mbcallahan/MATE/old code/readme.md

Old code from Christian  
Original repositories here: 
https://github.com/computer-whisperer
