mbcallahan/MATE/electrical/footprints/readme.md

FC4L64, ODROID-C2 by Connor Crenshaw
PJ-002AH by manufacturer, modified to include silkscreen warning
