mbcallahan/MATE/electrical/control board/BOM 2-4-2019.xlsx

C1 | .22uF | Capacitor_SMD:C_0603_1608Metric_Pad1.05x0.95mm_HandSolder | 490-8017-1-ND | 1
> C2, C3 | 30pF | Capacitor_SMD:C_0603_1608Metric_Pad1.05x0.95mm_HandSolder | 1276-1021-1-ND | 2
> C4, C17 | .1uF | Capacitor_SMD:C_0603_1608Metric_Pad1.05x0.95mm_HandSolder | 1276-1005-1-ND | 2
> C5 - C12 | 100nF | Capacitor_SMD:C_0603_1608Metric_Pad1.05x0.95mm_HandSolder | 1276-1005-1-ND | 8
> C13, C14 | 1uF | Capacitor_SMD:C_0603_1608Metric_Pad1.05x0.95mm_HandSolder | 1276-1102-1-ND | 2
> C15, C16 | 10uF | Capacitor_SMD:C_0603_1608Metric_Pad1.05x0.95mm_HandSolder | 490-10728-1-ND | 2
C18 | 2.2uF | Capacitor_SMD:C_0603_1608Metric_Pad1.05x0.95mm_HandSolder | 490-10731-1-ND | 1
> D1, D4 | LED-RED | LED_SMD:LED_0603_1608Metric_Pad1.05x0.95mm_HandSolder | SML-D12U1WT86CT-ND | 2
> D2, D5 | LED-YELLOW | LED_SMD:LED_0603_1608Metric_Pad1.05x0.95mm_HandSolder | 160-1448-1-ND | 2
> D3, D6 | LED-GREEN | LED_SMD:LED_0603_1608Metric_Pad1.05x0.95mm_HandSolder | 160-1446-1-ND | 2
J1 | analog_extra | Connector_PinHeader_2.54mm:PinHeader_1x02_P2.54mm_Vertical | HDR100IMP40M-G-V-TH-ND | 1
J2 | Programming_Header | Connector_PinHeader_2.54mm:PinHeader_1x06_P2.54mm_Vertical | HDR100IMP40M-G-V-TH-ND | 1
J3 | USB_B | Connector_USB:USB_B_OST_USB-B1HSxx_Horizontal | UE27BC54130-ND | 1
J4 | datamate_sensors | Connector_Harwin:Harwin_LTek-Male_04_P2.00mm_Vertical | 952-1071-5-ND | 1
J5 | Motor_1 | Connector_Harwin:Harwin_LTek-Male_03_P2.00mm_Vertical | 952-1070-5-ND‎ | 1
J6 | datamate_misc | Connector_Harwin:Harwin_LTek-Male_04_P2.00mm_Vertical | 952-1071-5-ND | 1
J7 | Power_Connector | Connector_Molex:Molex_Mini-Fit_Jr_5566-08A2_2x04_P4.20mm_Vertical | WM3803-ND | 1
J8 | Power_Header | footprints:1x2 individual header | HDR100IMP40M-G-V-TH-ND | 1
J9 | Switch_Connector | Connector_Harwin:Harwin_LTek-Male_06_P2.00mm_Vertical | 952-1072-5-ND | 1
J10 | Motor_2 | Connector_Harwin:Harwin_LTek-Male_03_P2.00mm_Vertical | 952-1070-5-ND‎ | 1
J11 | Motor_3 | Connector_Harwin:Harwin_LTek-Male_03_P2.00mm_Vertical | 952-1070-5-ND‎ | 1
J12 | Motor_4 | Connector_Harwin:Harwin_LTek-Male_03_P2.00mm_Vertical | 952-1070-5-ND‎ | 1
J13 | Motor_5 | Connector_Harwin:Harwin_LTek-Male_03_P2.00mm_Vertical | 952-1070-5-ND‎ | 1
J14 | Motor_6 | Connector_Harwin:Harwin_LTek-Male_03_P2.00mm_Vertical | 952-1070-5-ND‎ | 1
J15 | Motor_7 | Connector_Harwin:Harwin_LTek-Male_03_P2.00mm_Vertical | 952-1070-5-ND‎ | 1
J16 | Motor_8 | Connector_Harwin:Harwin_LTek-Male_03_P2.00mm_Vertical | 952-1070-5-ND‎ | 1
J17 | USB_to_5V | Connector_PinHeader_2.54mm:PinHeader_1x02_P2.54mm_Vertical | HDR100IMP40M-G-V-TH-ND | 1
J18 | Storage | Connector_PinHeader_2.54mm:PinHeader_1x02_P2.54mm_Vertical | HDR100IMP40M-G-V-TH-ND | 1
P1 | ODROID-C2 | footprints:ODROID-C2 | SAM9012-ND | 1
Q2 | DTC114E | Package_TO_SOT_SMD:SOT-23 | DTC114EET1GOSCT-ND | 1
> R1, R2 | 2.2k | Resistor_SMD:R_0603_1608Metric_Pad1.05x0.95mm_HandSolder | A130093CT-ND | 2
> R3 - R13 | 10k | Resistor_SMD:R_0603_1608Metric_Pad1.05x0.95mm_HandSolder | CR0603-JW-103ELFCT-ND | 4
R8 | 56k | Resistor_SMD:R_0603_1608Metric_Pad1.05x0.95mm_HandSolder | RMCF0603JT56K0CT-ND | 1
> R9 - R19 | 220 | Resistor_SMD:R_0603_1608Metric_Pad1.05x0.95mm_HandSolder | A130087CT-ND | 6
R14 | 12k | Resistor_SMD:R_0603_1608Metric_Pad1.05x0.95mm_HandSolder | CR0603-JW-123ELFCT-ND | 1
R15 | 100k | Resistor_SMD:R_0603_1608Metric_Pad1.05x0.95mm_HandSolder | CR0603-JW-104ELFCT-ND | 1
R16 | 3.6k | Resistor_SMD:R_0603_1608Metric_Pad1.05x0.95mm_HandSolder | RMCF0603JT3K60CT-ND | 1
SW1 | SW_Push | Button_Switch_SMD:SW_SPST_PTS645 | PTS645SM43SMTR92 LFS | 1
U1 | STM32F446RETx | footprints:LQFP-64_10x10mm_P0.5mm_handsolder | 497-15376-ND | 1
U2 | HIH6131-021 | Package_SO:SOIC-8_3.9x4.9mm_P1.27mm | 480-3652-1-ND | 1
U3 | LD1117S33TR_SOT223 | Package_TO_SOT_SMD:SOT-223-3_TabPin2 | 497-1242-1-ND | 1
U5 | BMI160 | Package_LGA:LGA-14_3x2.5mm_P0.5mm_LayoutBorder3x4y | 828-1057-1-ND | 1
> U4, U6 | ADM3061 | Package_SO:TSSOP-8_3x3mm_P0.65mm | ADM3061EARMZ-ND | 2
Y1 | 8Mhz | Crystal:Crystal_HC49-U_Vertical | CTX917-ND‎ | 1
 |  | 6 wire ribbon cable | 1568-1938-ND | 1
 |  | Molex cable | WM8399-ND | 2
 |  | Datamate female | 952-1764-ND | 8
 |  | Jumper | S9337-ND | 1
