mbcallahan/MATE/electrical/control board/pin budget.xlsx

Item | Number of item | I2C | UART | GPIO | Analog
HIH6031 | 1 | 1 | 0 | 0 | 0
INA 240 | 1 | 0 | 0 | 0 | 1
ADM3061(RS485) | 3 | 0 | 1 | 0 | 0
ICM20648 (measury thingy) | 1 | 1 | 0 | 0 | 0
Odroid | 1 | 0 | 1 | 0 | 0
5V | 1 | 0 | 0 | 0 | 1
3.3V | 1 | 0 | 0 | 0 | 1
48V | 1 | 0 | 0 | 0 | 1
low side switch | 4 | 0 | 0 | 1 | 0
debug LED | 5 | 0 | 0 | 1 | 0
motor driver | 8 | 0 | 0 | 1 | 0 | Total pins:
Total | 27 | 2 | 4 | 17 | 4 | 33
Microcontroller | Package | I2C | UART | GPIO | Analog | Total (pins, not interfaces) | Notes
STM32 | SMD 64 | 2 | 4 | 20 | 20 | 48 | All GPIOs are also analog inputs
ATMEGA328p | SMD 32 |  | 1 | 20 | 8 | 26 | 6 analog inputs are also GPIOs
AtMega64 | SMD 64
