mbcallahan/MATE/(list of files, cad)

Other CAD files:
electrical/control board/outline.FCStd
electrical/control board/outline.dxf
