mbcallahan/MATE/electrical/control board power/control board power.kicad_pcb

## KiCad design electrical/control board power/control board power.kicad_pcb (2019-03-28)

Schematic: control board power.sch

Parts:
C1, C2: 10uF; C_0603_1608Metric_Pad1.05x0.95mm_HandSolder; Digikey part number 490-7198-1-ND
C3, C4, C19, C20: 2.2uF; C_1210_3225Metric_Pad1.42x2.65mm_HandSolder; Digikey part number 445-4497-1-ND
C5, C7: 1uF; C_0603_1608Metric_Pad1.05x0.95mm_HandSolder; Digikey part number 478-5010-1-ND
C6, C8: .1uF; C_0603_1608Metric_Pad1.05x0.95mm_HandSolder; Digikey part number 399-1100-1-ND
C9: 10pF; C_0603_1608Metric_Pad1.05x0.95mm_HandSolder; Digikey part number 732-7760-1-ND
C10: 2.2nF; C_0603_1608Metric_Pad1.05x0.95mm_HandSolder; Digikey part number 732-8003-1-ND
C11: 100pF; C_0603_1608Metric_Pad1.05x0.95mm_HandSolder; Digikey part number 732-7947-1-ND
C12, C13, C15, C16, C17, C18: 22uF; C_1210_3225Metric_Pad1.42x2.65mm_HandSolder; Digikey part number 1276-1855-1-ND
C14, C25, C26, C27: 330u; CP_Radial_D18.0mm_P7.50mm; Digikey part number 493-16707-ND
C21, C22: 0.1uF; C_0805_2012Metric_Pad1.15x1.40mm_HandSolder; Digikey part number 732-12244-1-ND
C23, C24: 10uF; C_1210_3225Metric_Pad1.42x2.65mm_HandSolder; Digikey part number 1276-3307-1-ND
D1: LED; LED_0603_1608Metric_Pad1.05x0.95mm_HandSolder_diode_mark; Digikey part number SML-D12U1WT86CT-ND
D2: LED; LED_0603_1608Metric_Pad1.05x0.95mm_HandSolder_diode_mark; Digikey part number 160-1446-1-ND
D3: LED; LED_0603_1608Metric_Pad1.05x0.95mm_HandSolder_diode_mark; Digikey part number 846-1178-2-ND
D4, D5: LED; LED_0603_1608Metric_Pad1.05x0.95mm_HandSolder_diode_mark; Digikey part number 1830-1071-1-ND
D8: LED; LED_0603_1608Metric_Pad1.05x0.95mm_HandSolder_diode_mark; Digikey part number 754-2180-1-ND
D9, D10: D_Small; D_SMC_Handsoldering_Diode_Mark; Digikey part number SMCJ150CALFCT-ND
J1: Conn_01x02; Molex_Mini-Fit_Jr_5566-02A_2x01_P4.20mm_Vertical; Digikey part number N/A
J2: 5V; PinHeader_1x02_P2.54mm_Vertical; Digikey part number N/A
J3: Barrel_Jack; CUI_PJ-002AH; Digikey part number CP-002AH-ND
J4: Switch_A; Molex_Mini-Fit_Jr_5566-02A_2x01_P4.20mm_Vertical; Digikey part number WM8360-ND
J5: Conn_01x03; Harwin_LTek-Male_03_P2.00mm_Vertical
J6: Power_Connector; Molex_Mini-Fit_Jr_5566-08A2_2x04_P4.20mm_Vertical; Digikey part number WM3803-ND
J7: Switch_A_High; Square_Pad_6mm; Digikey part number N/A
J8: Switch_B_High; Square_Pad_6mm; Digikey part number N/A
J9: Aux_1; Molex_Mini-Fit_Jr_5566-04A_2x02_P4.20mm_Vertical; Digikey part number WM8359-ND
J10: 48V_from_conversion; Molex_Mini-Fit_Jr_5566-02A_2x01_P4.20mm_Vertical; Digikey part number WM8360-ND
J11: Aux_2; Molex_Mini-Fit_Jr_5566-04A_2x02_P4.20mm_Vertical; Digikey part number WM8359-ND
J12, J13: Conn_01x04; TerminalBlock_TE_282834-4_1x04_P2.54mm_Horizontal; Digikey part number A98335-ND
J17: Switch_B; Molex_Mini-Fit_Jr_5566-02A_2x01_P4.20mm_Vertical; Digikey part number WM8360-ND
L1, L2: 33uH; L_Radial_D12.0mm_P6.00mm_MuRATA_1900R; Digikey part number 6100-330K-RC-ND
Q1, Q2: Q_NMOS_GDS; TO-252-3_2_Pin; Digikey part number BTS3046SDRATMA1CT-ND
R1: 330; R_0603_1608Metric_Pad1.05x0.95mm_HandSolder; Digikey part number CR0603-JW-331ELFCT-ND
R2, R12, R13: 150; R_0603_1608Metric_Pad1.05x0.95mm_HandSolder; Digikey part number RMCF0603JT150RCT-ND
R3: 9.4k; R_1206_3216Metric_Pad1.42x1.75mm_HandSolder; Digikey part number 408-1867-1-ND
R4, R5: 10k; R_0603_1608Metric_Pad1.05x0.95mm_HandSolder; Digikey part number N/A
R7: 100k; R_0603_1608Metric_Pad1.05x0.95mm_HandSolder; Digikey part number 311-100KHRCT-ND
R8: 4.02k; R_0603_1608Metric_Pad1.05x0.95mm_HandSolder; Digikey part number RMCF0603FT4K02CT-ND
R10: 5.11k; R_0603_1608Metric_Pad1.05x0.95mm_HandSolder; Digikey part number RMCF0603FT5K11CT-ND
R16: 2.7k; R_1206_3216Metric_Pad1.42x1.75mm_HandSolder; Digikey part number 408-1906-1-ND
TB1: Curtis_2010; Digikey part number 364-1381-ND
TB2: Curtis_2010; Digikey part number 364-1381-ND
U1: LD1117S33TR_SOT223; SOT-223-3_TabPin2; Digikey part number 497-1242-1-ND
U2, U3: LTC7103-LT7103; LTC7103_long_pads_hole; Digikey part number LTC7103HUHE#TRPBFCT-ND

Connections:
+3V3: C2.1, C25.1, J6.5, J9.3, J11.3, R2.2, U1.2 (VO)
+5V: C1.1, C12.1, C13.1, C14.1, C15.1, C16.1, C17.1, C18.1, J2.1, J6.6, J9.4, J11.4, J12.1, J12.3, J13.1, J13.3, L1.2, L2.2, R1.2, U1.3 (VI), U2.20, U3.10, U3.20
+24V: C26.1, J1.1, J1.2, J6.7, R16.1
+48V: C3.1, C4.1, C19.1, C20.1, C21.1, C22.1, C27.1, J3.1, J6.8, J10.1, J10.2, R3.1, U2.3, U2.30, U2.31, U2.32, U3.3, U3.30, U3.31, U3.32
/SWITCH_A: J5.1, Q1.1, R4.1, R12.2
/SWITCH_A_HIGH: C23.2, D9.1, J4.1, J7.1
/SWITCH_B: J5.2, Q2.1, R5.1, R13.2
/SWITCH_B_HIGH: C24.2, D10.1, J8.1, J17.1
GND: C1.2, C2.2, C3.2, C4.2, C5.2, C7.2, C9.2, C11.1, C12.2, C13.2, C14.2, C15.2, C16.2, C17.2, C18.2, C19.2, C20.2, C21.2, C22.2, C23.1, C24.1, C25.2, C26.2, C27.2, D1.1, D2.1, D3.1, D4.1, D5.1, D8.1, J2.2, J3.2, J5.3, J6.1, J6.2, J6.3, J6.4, J9.1, J9.2, J11.1, J11.2, J12.2, J12.4, J13.2, J13.4, Q1.3, Q2.3, R4.2, R5.2, R8.2, R10.2, U1.1 (GND), U2.6, U2.7, U2.11, U2.35, U2.36, U2.37, U3.6, U3.7, U3.11, U3.19, U3.35, U3.36, U3.37
unnamed: C5.1, U2.10, U2.21
unnamed: C6.1, U2.27
unnamed: C6.2, L1.1, U2.24, U2.25, U2.26
unnamed: C7.1, R7.2, U3.21
unnamed: C8.1, U3.27
unnamed: C8.2, L2.1, U3.24, U3.25, U3.26
unnamed: C9.1, U2.9
unnamed: C10.1, R10.1
unnamed: C10.2, C11.2, U2.16, U3.9
unnamed: D1.2, R1.1
unnamed: D2.2, R2.1
unnamed: D3.2, R3.2
unnamed: D4.2, R12.1
unnamed: D5.2, R13.1
unnamed: D8.2, R16.2
unnamed: D9.2, J4.2, Q1.2
unnamed: D10.2, J17.2, Q2.2
unnamed: R7.1, U3.12
unnamed: R8.1, U2.8
unnamed: U2.12, U3.13
unnamed: U2.15, U3.15

Notes on the sheet:
Power Indicators
Power
Check regulator is correct voltage
Check capacitor voltage ratings!!!
Look at Connor's 5V converter board to check component ratings, etc.
DO NOT CONNECT 12V AND 48V SIMUTANIOUSLY!!!!
Note: Stack terminal blocks

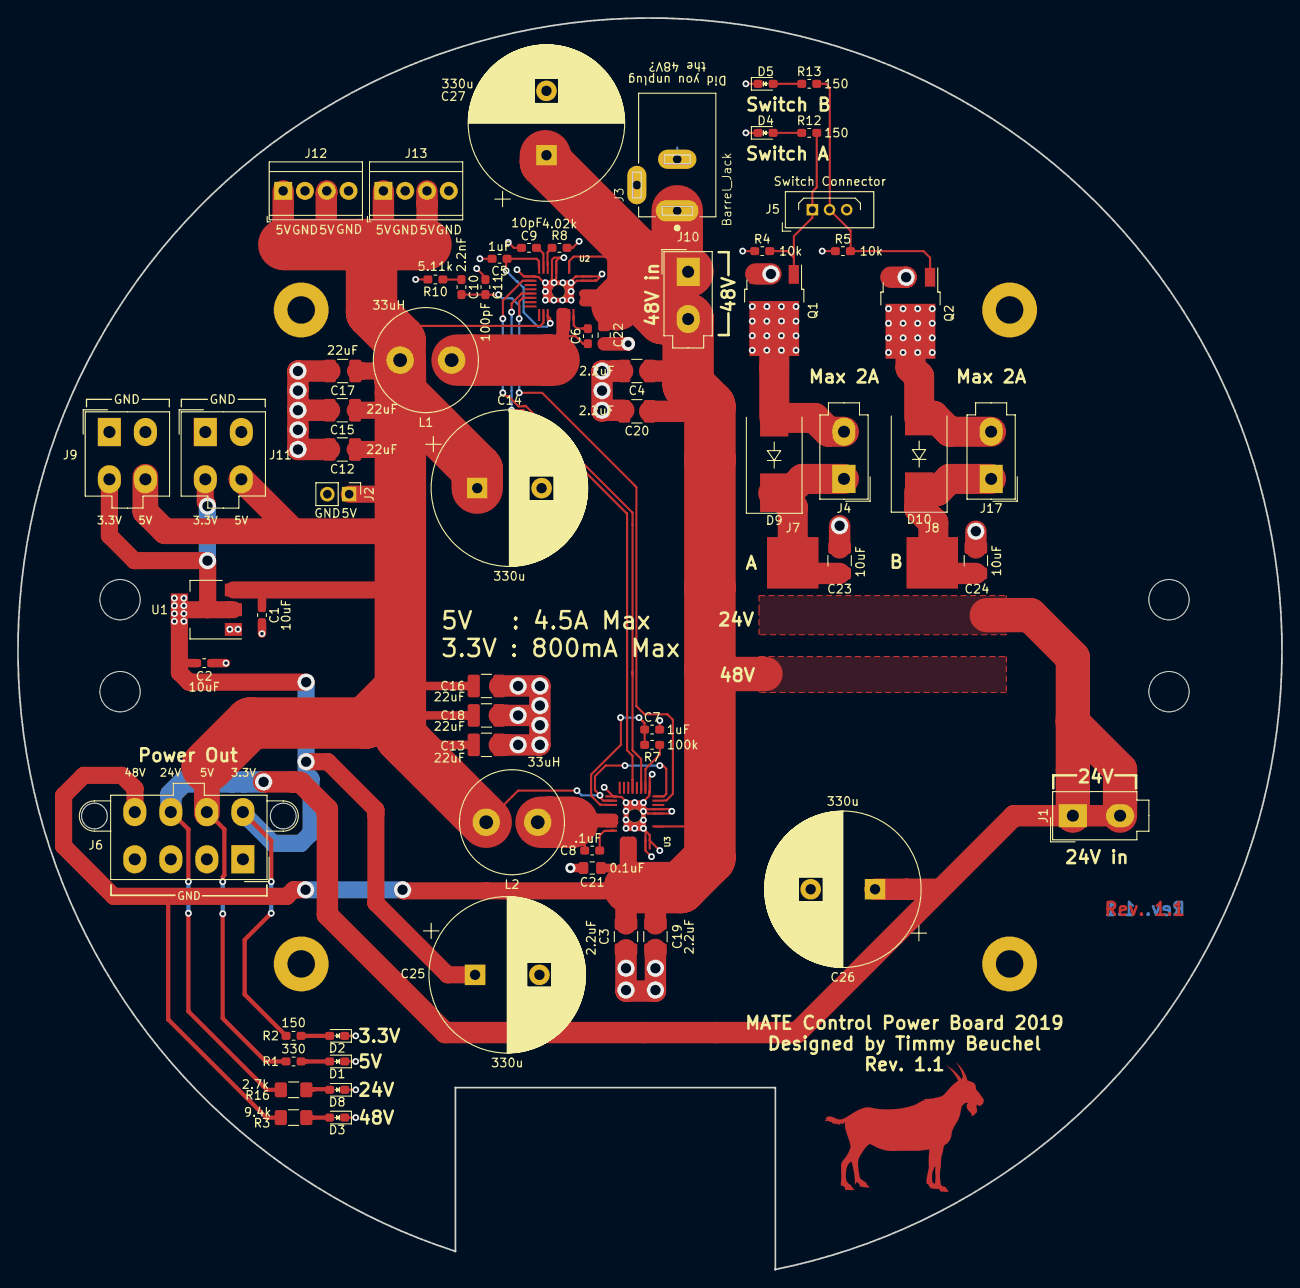
[picture p4: board control board power.kicad_pcb from above]

Board: 2 copper layers, 147.3 x 145.8 mm, 68 parts (1 on the bottom side), 30 nets.
