mbcallahan/MATE/electrical/control board/control board.kicad_pcb

## KiCad design electrical/control board/control board.kicad_pcb (2019-02-27)

Schematic: control board.sch

Parts:
C1: .22uF; C_0603_1608Metric_Pad1.05x0.95mm_HandSolder; Digikey part number 490-8017-1-ND
C2, C3: 30pF; C_0603_1608Metric_Pad1.05x0.95mm_HandSolder; Digikey part number 1276-1021-1-ND
C4, C17: .1uF; C_0603_1608Metric_Pad1.05x0.95mm_HandSolder; Digikey part number 1276-1005-1-ND
C5, C6, C7, C8, C9, C10, C11, C12: 100nF; C_0603_1608Metric_Pad1.05x0.95mm_HandSolder; Digikey part number 1276-1005-1-ND
C13, C14: 1uF; C_0603_1608Metric_Pad1.05x0.95mm_HandSolder; Digikey part number 1276-1102-1-ND
C15, C16: 10uF; C_0603_1608Metric_Pad1.05x0.95mm_HandSolder; Digikey part number 490-10728-1-ND
C18: 2.2uF; C_0603_1608Metric_Pad1.05x0.95mm_HandSolder; Digikey part number 490-10731-1-ND
D1, D4: LED-RED; LED_0603_1608Metric_Pad1.05x0.95mm_HandSolder; Digikey part number SML-D12U1WT86CT-ND
D2, D5, D7: LED-YELLOW; LED_0603_1608Metric_Pad1.05x0.95mm_HandSolder; Digikey part number 160-1448-1-ND
D3, D6, D8: LED-GREEN; LED_0603_1608Metric_Pad1.05x0.95mm_HandSolder; Digikey part number 160-1446-1-ND
J1: analog_extra; PinHeader_1x02_P2.54mm_Vertical; Digikey part number HDR100IMP40M-G-V-TH-ND
J2: Programming_Header; PinHeader_1x06_P2.54mm_Vertical; Digikey part number HDR100IMP40M-G-V-TH-ND
J3: USB_B; USB_B_OST_USB-B1HSxx_Horizontal; Digikey part number UE27BC54130-ND
J4: datamate_sensors; Harwin_LTek-Male_04_P2.00mm_Vertical; Digikey part number 952-1071-5-ND
J5: Motor_1; Harwin_LTek-Male_03_P2.00mm_Vertical; Digikey part number 952-1070-5-ND‎
J6: datamate_misc; Harwin_LTek-Male_04_P2.00mm_Vertical; Digikey part number 952-1071-5-ND
J7: Power_Connector; Molex_Mini-Fit_Jr_5566-08A2_2x04_P4.20mm_Vertical; Digikey part number WM3803-ND
J8: Power_Header; 1x2 individual header; Digikey part number HDR100IMP40M-G-V-TH-ND
J9: Switch_Connector; Harwin_LTek-Male_06_P2.00mm_Vertical; Digikey part number 952-1072-5-ND
J10: Motor_2; Harwin_LTek-Male_03_P2.00mm_Vertical; Digikey part number 952-1070-5-ND‎
J11: Motor_3; Harwin_LTek-Male_03_P2.00mm_Vertical; Digikey part number 952-1070-5-ND‎
J12: Motor_4; Harwin_LTek-Male_03_P2.00mm_Vertical; Digikey part number 952-1070-5-ND‎
J13: Motor_5; Harwin_LTek-Male_03_P2.00mm_Vertical; Digikey part number 952-1070-5-ND‎
J14: Motor_6; Harwin_LTek-Male_03_P2.00mm_Vertical; Digikey part number 952-1070-5-ND‎
J15: Motor_7; Harwin_LTek-Male_03_P2.00mm_Vertical; Digikey part number 952-1070-5-ND‎
J16: Motor_8; Harwin_LTek-Male_03_P2.00mm_Vertical; Digikey part number 952-1070-5-ND‎
J17: USB_to_5V; PinHeader_1x02_P2.54mm_Vertical; Digikey part number HDR100IMP40M-G-V-TH-ND
J18: Storage; PinHeader_1x02_P2.54mm_Vertical; Digikey part number HDR100IMP40M-G-V-TH-ND
P1: ODROID-C2; Digikey part number SAM9012-ND
Q2: DTC114E; SOT-23; Digikey part number DTC114EET1GOSCT-ND
R1, R2: 2.2k; R_0603_1608Metric_Pad1.05x0.95mm_HandSolder; Digikey part number A130093CT-ND
R3, R4, R7, R13: 10k; R_0603_1608Metric_Pad1.05x0.95mm_HandSolder; Digikey part number CR0603-JW-103ELFCT-ND
R5, R9, R10, R11, R17, R18, R19: 68; R_0603_1608Metric_Pad1.05x0.95mm_HandSolder; Digikey part number RMCF0603JT68R0CT-ND
R6: 180; R_0603_1608Metric_Pad1.05x0.95mm_HandSolder
R8: 56k; R_0603_1608Metric_Pad1.05x0.95mm_HandSolder; Digikey part number RMCF0603JT56K0CT-ND
R12, R15: 100k; R_0603_1608Metric_Pad1.05x0.95mm_HandSolder; Digikey part number CR0603-JW-104ELFCT-ND
R14: 12k; R_0603_1608Metric_Pad1.05x0.95mm_HandSolder; Digikey part number CR0603-JW-123ELFCT-ND
R16: 3.6k; R_0603_1608Metric_Pad1.05x0.95mm_HandSolder; Digikey part number RMCF0603JT3K60CT-ND
R20: 6.6k; R_0603_1608Metric_Pad1.05x0.95mm_HandSolder; Digikey part number A129698CT-ND
SW1: SW_Push; SW_SPST_PTS645; Digikey part number CKN9112CT-ND
U1: STM32F446RETx; LQFP-64_10x10mm_P0.5mm_handsolder; Digikey part number 497-15376-ND
U2: HIH6131-021; SOIC-8_3.9x4.9mm_P1.27mm; Digikey part number 480-3652-1-ND
U3: LD1117S33TR_SOT223; SOT-223-3_TabPin2; Digikey part number 497-1242-1-ND
U4, U6: ADM3061; TSSOP-8_3x3mm_P0.65mm; Digikey part number ADM3061EARMZ-ND
U5: BMI160; LGA-14_3x2.5mm_P0.5mm_pads_shrunk; Digikey part number 828-1057-1-ND
Y1: 8Mhz; Crystal_HC49-U_Vertical; Digikey part number CTX917-ND‎

Connections:
+3V3: C1.2, C4.2, C5.2, C6.2, C7.2, C8.2, C9.2, C10.2, C11.1, C12.1, C13.1, C14.1, C16.1, J2.1, J7.5, J8.2, R1.1, R2.1, R3.2, R4.2, R5.2, R7.1, U1.1 (VBAT), U1.13 (VDDA), U1.19 (VDD), U1.32 (VDD), U1.48 (VDD), U1.64 (VDD), U2.8, U3.2 (VO), U4.8, U5.5, U5.8, U5.12, U6.8
+5V: J7.6, J17.1, P1.2, P1.4, R6.2, R13.1
+24V: J7.7, R12.1
+48V: J4.1, J6.1, J7.8, R15.1
/3.3V_MEASURE: R7.2, R8.1, U1.8 (PC0)
/5V_MEASURE: R13.2, R14.1, U1.9 (PC1)
/24V_MEASURE: R12.2, R20.1, U1.27 (PB1)
/48V_MEASURE: R15.2, R16.1, U1.10 (PC2)
/CURRENT_MEASURE: U1.11 (PC3)
/HIH_SCL: R1.2, U1.37 (PC6), U2.3
/HIH_SDA: R2.2, U1.38 (PC7), U2.4
/ICM_SCL: R4.1, U1.41 (PA8), U5.13
/ICM_SDA: R3.1, U1.40 (PC9), U5.14
/JTDO: J2.6, U1.55 (PB3)
/MISC_DE: U1.3 (PC14), U6.3
/MISC_RE: U1.2 (PC13), U6.2
/MISC_RX: U1.52 (PC11), U6.1
/MISC_TX: U1.51 (PC10), U6.4
/MOTOR_1: J5.3, U1.4 (PC15)
/MOTOR_2: J10.3, U1.62 (PB9)
/MOTOR_3: J11.3, U1.61 (PB8)
/MOTOR_4: J12.3, U1.57 (PB5)
/MOTOR_5: J13.3, U1.56 (PB4)
/MOTOR_6: J14.3, U1.54 (PD2)
/MOTOR_7: J15.3, U1.53 (PC12)
/MOTOR_8: J16.3, U1.50 (PA15)
/NRST: C17.1, J2.5, Q2.3, SW1.1, U1.7 (NRST)
/ODROID_RX: P1.10, U1.14 (PA0)
/ODROID_TX: P1.8, U1.15 (PA1)
/SENSOR_DE: U1.45 (PA12), U4.3
/SENSOR_RE: U1.44 (PA11), U4.2
/SENSOR_RX: U1.43 (PA10), U4.1
/SENSOR_TX: U1.42 (PA9), U4.4
/STM_RESET: P1.7, Q2.1
/SWCLK: J2.2, U1.49 (PA14)
/SWDIO: J2.4, U1.46 (PA13)
/SWITCH_A: J9.6, U1.29 (PB10)
/SWITCH_B: J9.5, U1.33 (PB12)
/SWITCH_C: J9.4, U1.34 (PB13)
/SWITCH_D: J9.3, U1.35 (PB14)
/SWITCH_E: J9.2, U1.36 (PB15)
/USART1_RX: U1.59 (PB7)
/USART1_TX: U1.58 (PB6)
unnamed: C2.1, U1.5 (PH0), Y1.1
unnamed: C3.1, U1.6 (PH1), Y1.2
unnamed: C4.1, U2.1
unnamed: C15.1, J3.1, J17.2, U3.3 (VI)
unnamed: C18.1, U1.30 (VCAP_1)
unnamed: D1.2, R9.2
unnamed: D2.2, R10.1
unnamed: D3.2, R11.1
unnamed: D4.2, R17.1
unnamed: D5.2, R18.1
unnamed: D6.2, R19.1
unnamed: D7.2, R5.1
unnamed: D8.2, R6.1
unnamed: J1.2, U1.24 (PC4)
unnamed: J4.2, U4.7
unnamed: J4.3, U4.6
unnamed: J6.2, U6.7
unnamed: J6.3, U6.6
unnamed: P1.33, R17.2
unnamed: P1.35, R18.2
unnamed: P1.37, R19.2
unnamed: R9.1, U1.16 (PA2)
unnamed: R10.2, U1.17 (PA3)
unnamed: R11.2, U1.20 (PA4)

Notes on the sheet:
USART6_TX
USART6_RX
UART4 : Odroid UART2 : Motors UART1 : Sensors UART3 : Misc
Voltage Monitering
Consider moving to power board
Add header space for current measurement
Not connected to +5V to avoid overcurrent on USB port attempting to power odroid
Consider adding switch instead

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
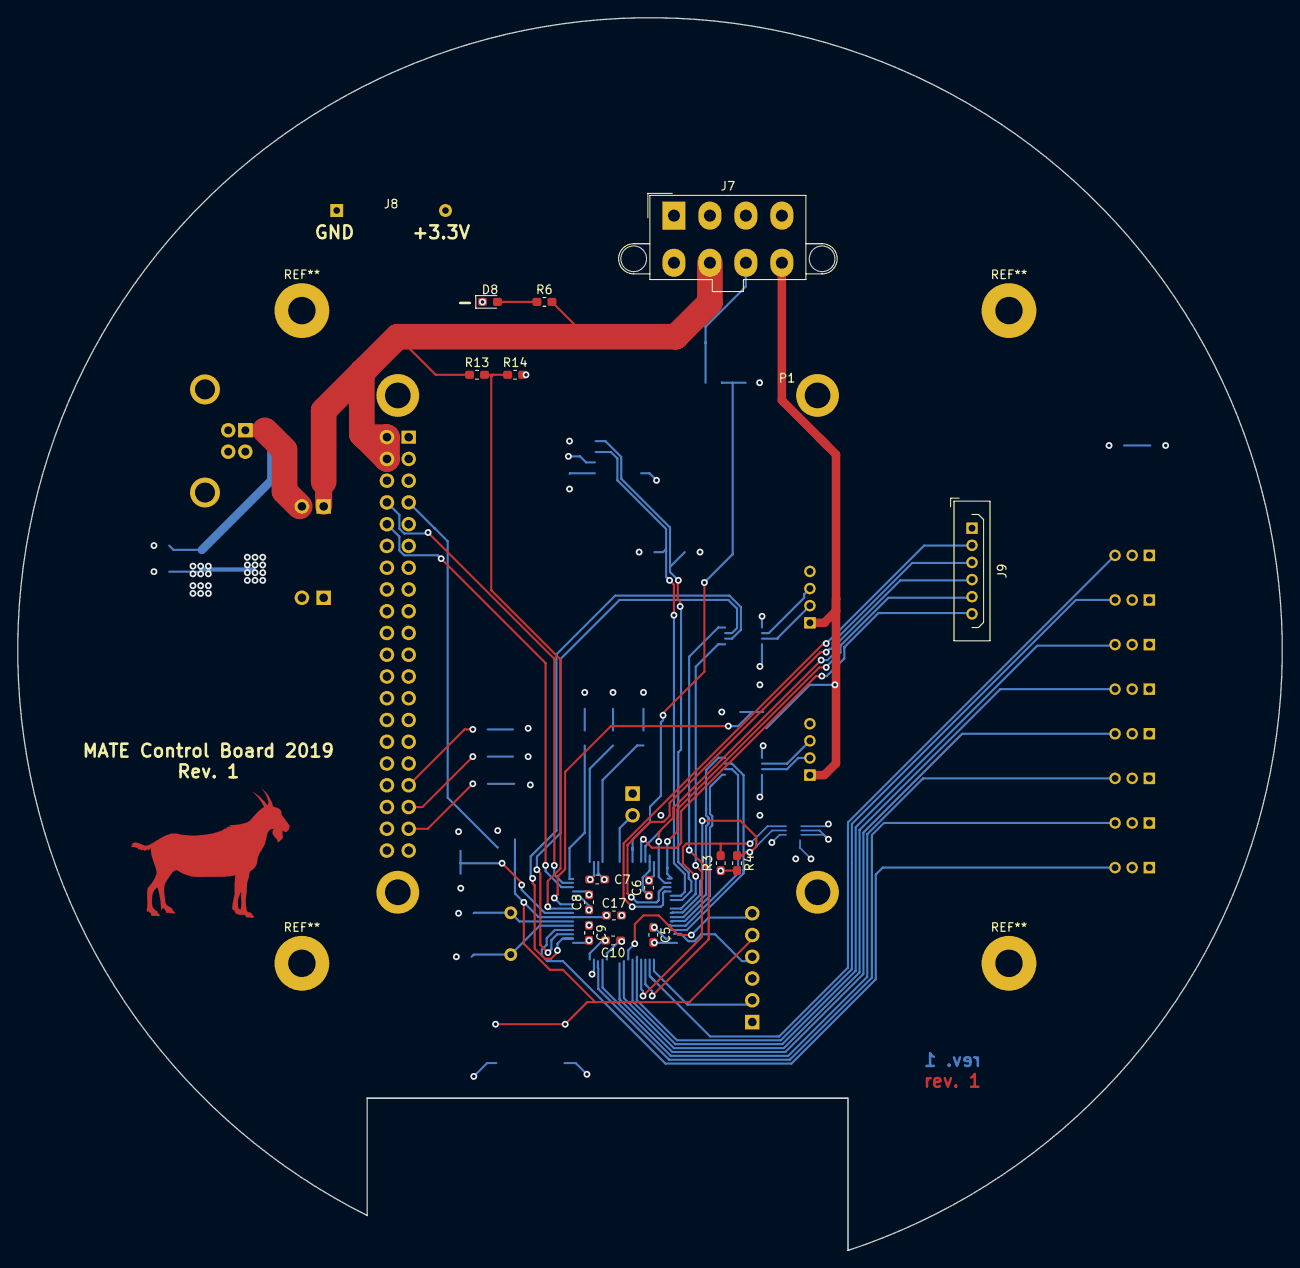
[picture p5: board control board.kicad_pcb from above]

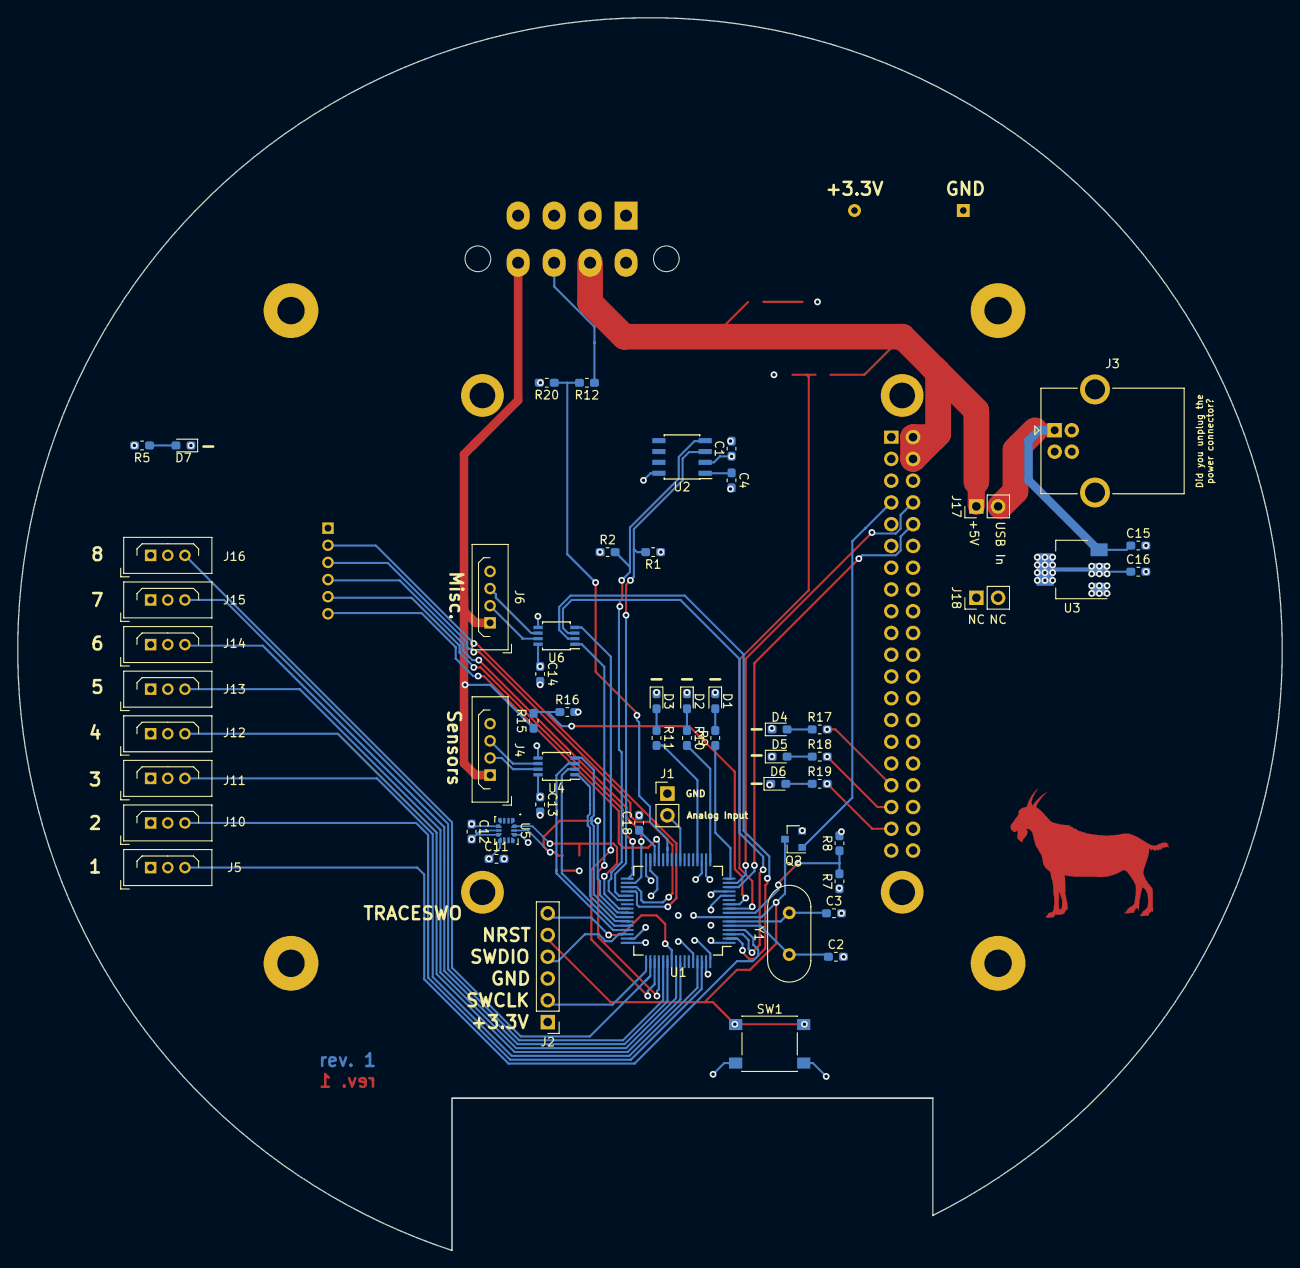
[picture p6: board control board.kicad_pcb from below]

Board: 4 copper layers, 147.6 x 143.9 mm, 74 parts (57 on the bottom side), 65 nets.
