mbcallahan/MATE/(commit log)

2018-12-10 Added old code
    [robot.yml]
2018-12-23 added controlboard
    [control board.kicad_pcb, control board.sch, current budget.xlsx, pin budget.xlsx]
2018-12-23 removed motor communications
    [control board.sch]
2018-12-23 new interface with motor drivers
    [control board.sch]
2018-12-24 deleted previous board
    [control board.kicad_pcb]
2018-12-24 moved power section of control board into a seperate project
    [control board power.kicad_pcb, control board power.sch]
2018-12-24 made a mess, then fixed it
    [control board power.sch, control board.sch]
2018-12-24 transfered power section to a new project
    for real this time
    [control board power.sch, control board.sch]
2018-12-25 Finally got the correct board outline in Kicad
    [_saved_control board.sch, control board power.kicad_pcb, control board.sch, outline.FCStd, outline.dxf]
2018-12-25 the correct board outline is now in the correct project
    For real this time, I promise
    [control board.kicad_pcb]
2018-12-25 some work on board
    [control board.kicad_pcb]
2018-12-25 Added footprint for power connector
    [_saved_control board.sch, control board.sch]
2018-12-25 Moved current measurement to power board
    [control board power.sch, control board.kicad_pcb, control board.sch]
2018-12-25 forgot to remove current measurement from pcb
    [control board.kicad_pcb]
2018-12-26 routed voltage measurement
    [control board.kicad_pcb, control board.sch]
2018-12-26 found a crystal
    [control board.kicad_pcb, control board.sch]
2018-12-27 Found parts for LEDs
    [control board.kicad_pcb, control board.sch]
2018-12-27 leds are sort of aded
    [_saved_control board.sch, control board.kicad_pcb]
2018-12-27 destoryed a lot of stuff around the microcontroller
    [control board.kicad_pcb]
2018-12-27 created hand solder footprint for microcontoller
    [_saved_control board.sch, control board.sch]
2018-12-27 Changed pins on motors
    [control board.kicad_pcb, control board.sch]
2018-12-28 board is mostly routed
    [control board.kicad_pcb]
2018-12-28 control board is almost finished
    [control board.kicad_pcb]
2018-12-28 added low side switches to control board power
    [control board power.sch, control board.kicad_pcb]
2018-12-30 made a footprint with long pads and a hole in the middle
    [control board power.kicad_pcb, control board power.sch]
2018-12-30 made a mess
    [control board power.kicad_pcb]
2018-12-30 fixed the mess
    [control board power.kicad_pcb]
2018-12-31 more stuff
    [control board power.kicad_pcb]
2018-12-31 found a part for the barrel jack
    [control board power.kicad_pcb, control board power.sch]
2019-01-08 found parts for most of the stuff on the control board
    [control board power.kicad_pcb, control board power.sch, control board.sch, test.csv]
2019-01-08 replaced the footprints of the data headers
    [control board.kicad_pcb]
2019-01-08 replaced the motor headers
    [control board.kicad_pcb, control board.sch]
2019-02-02 capacitors are no longer in microcontroller
    [control board.kicad_pcb]
2019-02-02 replaced sensor with BMI160
    [control board.sch]
2019-02-02 routed new acceleration sensor
    [control board.kicad_pcb, control board.sch]
2019-02-02 placed mounting holes (m3 for now)
    [control board.kicad_pcb]
2019-02-02 added usb port and linear regulator
    [control board.kicad_pcb, control board.sch]
2019-02-02 moved motor headers
    [control board.kicad_pcb]
2019-02-02 replaced humidity sensor with one that exists
    [control board.sch]
2019-02-02 mostly finished routing control board
    [control board.kicad_pcb, control board.sch]
2019-02-02 added capacitors to linear regulator
    [control board.kicad_pcb, control board.sch]
2019-02-02 Added pads to access internal layers
    [control board.kicad_pcb, control board.sch]
2019-02-02 Marked diode polarity
    [control board.kicad_pcb]
2019-02-02 added reset button
    [control board.kicad_pcb, control board.sch]
2019-02-02 connected stuff
    [control board.kicad_pcb]
2019-02-03 Added low side switch connector
    [control board.kicad_pcb, control board.sch]
2019-02-03 rerouted some things
    [control board.kicad_pcb]
2019-02-03 cleaned up tracks and vias
    [control board.kicad_pcb]
2019-02-03 Fixed solder mask distance
    [control board.kicad_pcb]
2019-02-03 labelled stuff
    [control board.kicad_pcb]
2019-02-03 control board should be ready to order
    [control board.kicad_pcb]
2019-02-03 Found some part numbers
    [control board.sch]
2019-02-03 Found all part numbers
    [control board.sch]
2019-02-04 tweaked usb port
    [control board power.kicad_pcb, control board.kicad_pcb, control board.sch]
2019-02-05 Added power leds and bugfixes
    [_saved_control board.sch, control board.kicad_pcb, control board.sch]
2019-02-05 Added power indicators
    [control board.sch]
2019-02-05 Added 24V measurement
    [control board.kicad_pcb, control board.sch]
2019-02-05 Found parts
    [control board.kicad_pcb, control board.sch]
2019-02-05 Generated gerber files
    [control board-B.Cu.gbl, control board-B.Mask.gbs, control board-B.SilkS.gbo, control board-Edge.Cuts.gm1, control board-F.Cu.gtl, control board-F.Mask.gts, control board-F.SilkS.gto, control board.drl]
2019-02-06 Fixed trace seperatation
    [BOM 2-4-2019.xlsx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]
2019-02-06 Added some connectors to power board
    [control board power.sch]
2019-02-06 Added footprints for connectors
    [control board power.sch]
2019-02-06 power distribution board now has correct outline and mounting holes
    [control board power.kicad_pcb]
2019-02-07 changed footprint for motor headers
    [control board power.kicad_pcb, control board power.sch]
2019-02-07 routed things
    [control board power.kicad_pcb]
2019-02-07 assigned part number and footprint to transistors
    [control board power.kicad_pcb, control board power.sch]
2019-02-07 routed stuff
    [control board power.kicad_pcb]
2019-02-08 Added thermal vias to switches, just in case
    [control board power.kicad_pcb, control board power.sch]
2019-02-08 Moved motor connectors
    [control board power.kicad_pcb]
2019-02-08 added leds for low side switches
    [control board power.kicad_pcb, control board power.sch]
2019-02-08 added vias to regulator footprint
    [control board power.kicad_pcb]
2019-02-08 changed nano-fit footprint to have sort-of not intersecting pads
    [control board power.kicad_pcb, control board power.sch]
2019-02-08 Created terminal block symbol and footprint
    [control board power.kicad_pcb]
2019-02-09 Created symbol and footprint for other terminal strip
    [control board power.sch]
2019-02-09 replaced motor headers with mounting point for terminal block
    [control board power.sch]
2019-02-10 Rerouted the second regulator
    [control board power.kicad_pcb]
2019-02-11 Found some parts
    [_saved_control board power.sch, control board power.kicad_pcb, control board power.sch]
2019-02-11 Making the low side switches beefier
    [_saved_control board power.sch, control board power.kicad_pcb, control board power.sch]
2019-02-11 Added flyback diodes on low side switches
    [control board power.kicad_pcb, control board power.sch]
2019-02-11 Moved indicator leds
    [control board power.kicad_pcb]
2019-02-11 Switched location of low side switches
    [control board power.kicad_pcb, control board power.sch]
2019-02-12 added diode marks to diodes
    [control board power.kicad_pcb, control board power.sch]
2019-02-12 Added values for resistors
    [control board power.sch]
2019-02-12 Added some part numbers
    [control board power.sch]
2019-02-12 finished finding part numbers
    [control board power.sch]
2019-02-12 fixed 3.3v regulator part number
    [BOM 2-12-2019.xlsx, control board power.sch]
2019-02-13 fixed regulator part number
2019-02-16 Removed 2 low side switches
    [control board power.kicad_pcb, control board power.sch]
2019-02-16 Added 2 extra power connectors
    [control board power.sch]
2019-02-16 Added parts to board
    [control board power.sch]
2019-02-16 fixed unconnected parts
    [control board power.kicad_pcb]
2019-02-16 Removed most of the via in pads
    [control board power.kicad_pcb]
2019-02-27 odroid footprint now has correct pad dimentions
    [_saved_control board power.sch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]
2019-03-08 Removed current measurement from power board
    [_saved_control board power.sch, control board backup.kicad_pcb, control board backup.sch, control board power.kicad_pcb, control board power.sch]
2019-03-09 Lots of important stuff
    [control board power.kicad_pcb, control board power.sch]
2019-03-12 Added cutout for cables to pass by
    [control board power-B.Cu.gbl, control board power-B.Mask.gbs, control board power-B.SilkS.gbo, control board power-Edge.Cuts.gm1, control board power-F.Cu.gtl, control board power-F.Mask.gts, control board power-F.SilkS.gto, control board power.drl]
2019-03-12 Control power board ordered
    [control board power-B.Cu.gbl, control board power-B.Mask.gbs, control board power-B.SilkS.gbo, control board power-Edge.Cuts.gm1, control board power-F.Cu.gtl, control board power-F.Mask.gts, control board power-F.SilkS.gto, control board power.drl]
2019-03-25 Created primative documentation for control board
    Subject to change where future tense is present
2019-03-28 tweaked silkscreen and re-exported gerbers
    [control board power-B.Cu.gbl, control board power-B.Mask.gbs, control board power-B.SilkS.gbo, control board power-Edge.Cuts.gm1, control board power-F.Cu.gtl, control board power-F.Mask.gts, control board power-F.SilkS.gto, control board power.drl]
2019-03-28 added more documentation to the control board
